uiff/lorawan-wifi-ble-scanner/cad/export/Gehaeuse_Oben.stl

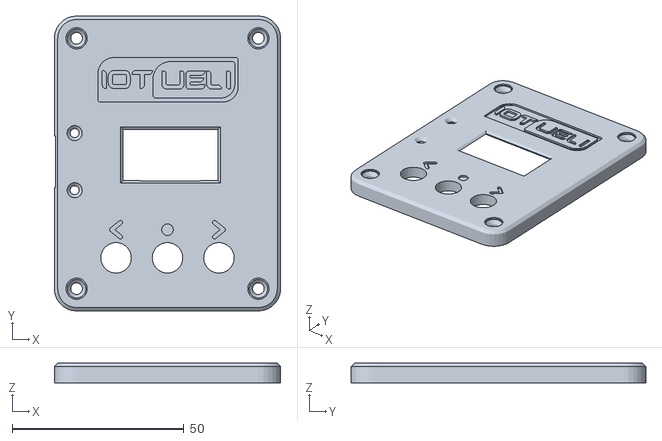
[picture p9: CAD file, 2026-10-29]
cad/export/Gehaeuse_Oben.stl
66.0 x 86.0 x 5.70
