uiff/lorawan-wifi-ble-scanner/cad/export/Gehaeuse_Unten.stl

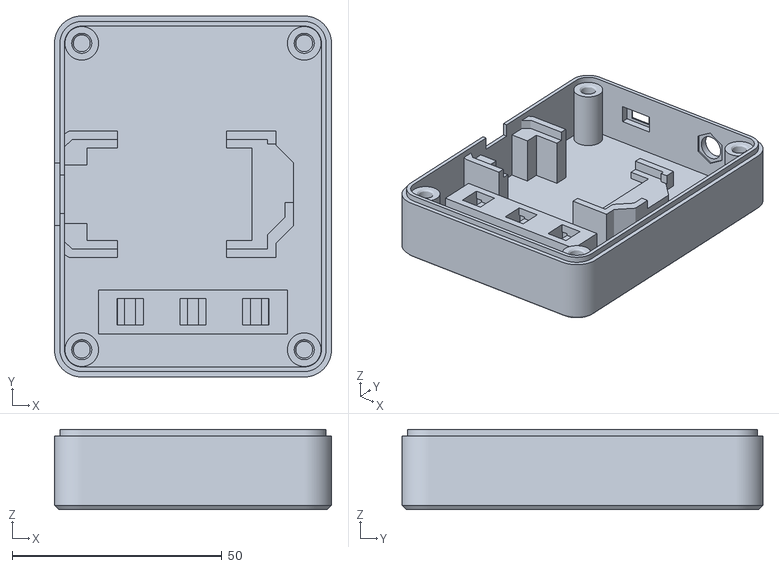
[picture p10: CAD file, 2026-10-29]
cad/export/Gehaeuse_Unten.stl
66.0 x 86.0 x 19.1
