uiff/lorawan-wifi-ble-scanner/cad/export/Taster_Kappe.stl

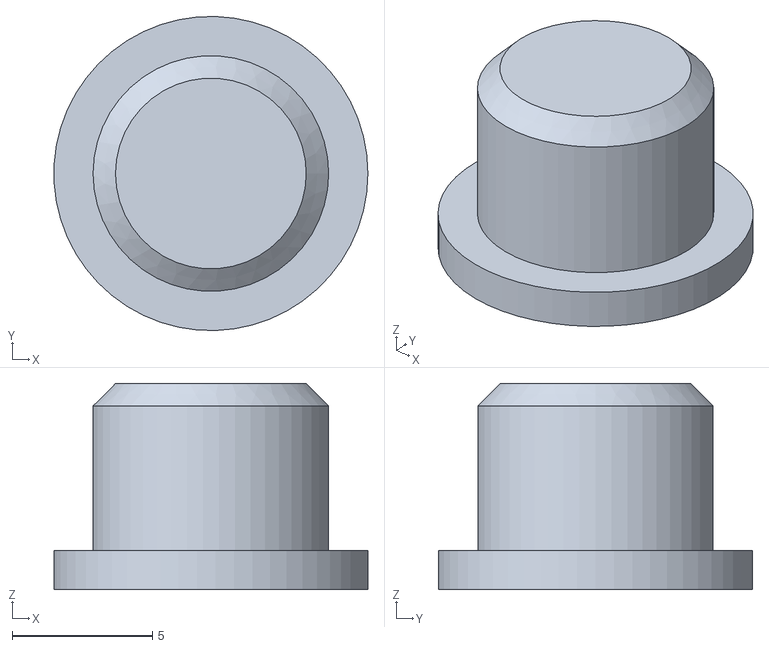
[picture p11: CAD file, 2026-10-29]
cad/export/Taster_Kappe.stl
11.2 x 11.2 x 7.35
