uiff/lorawan-wifi-ble-scanner/cad/export/LoraWanFinder_BambuLab_Platte.3mf

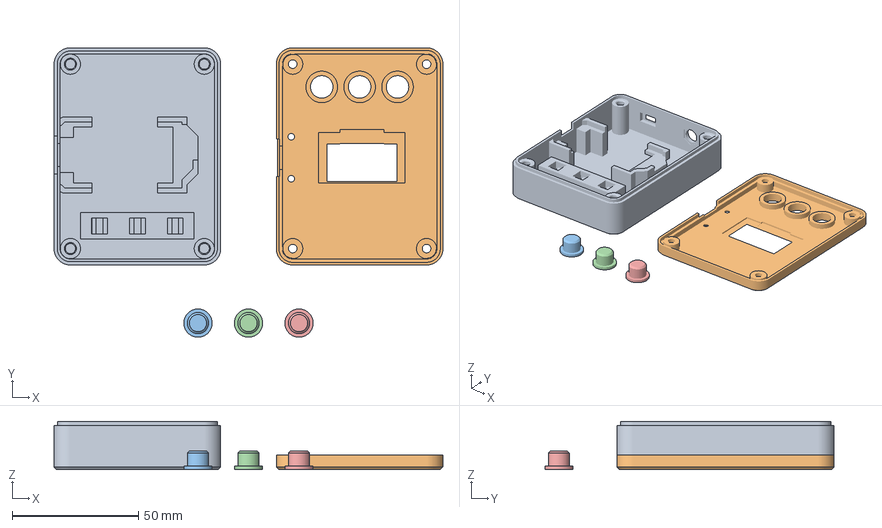
[picture p12: CAD file, 2026-10-29]
cad/export/LoraWanFinder_BambuLab_Platte.3mf
154.0 x 114.6 x 19.1 mm
Gehaeuse_Unten
Gehaeuse_Oben
Taster_Kappe_1
Taster_Kappe_2
Taster_Kappe_3
