uiff/lorawan-wifi-ble-scanner/cad/export/Logo_und_Tasten_Farbe2.stl

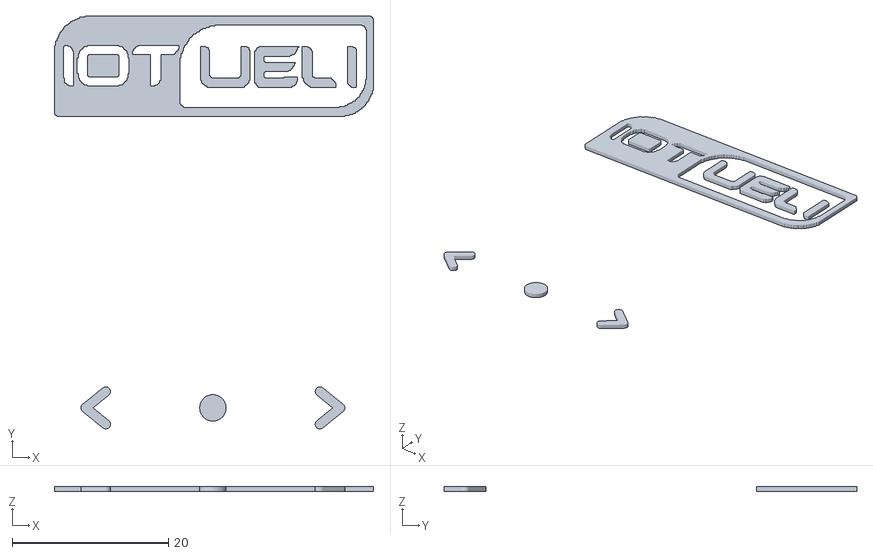
[picture p13: CAD file, 2026-10-29]
cad/export/Logo_und_Tasten_Farbe2.stl
40.8 x 52.9 x 0.6
