uiff/lorawan-wifi-ble-scanner/(commit log)

2026-10-29 Initial release: 3-in-1 LoRaWAN / WiFi / BLE Finder, Bambu Lab 3MF/STL enclosure (Rev. 5) & PDF manual
    [Gehaeuse_Oben.stl, Gehaeuse_Unten.stl, Logo_und_Tasten_Farbe2.stl, LoraWanFinder.FCStd, LoraWanFinder_BambuLab_Platte.3mf, Taster_Kappe.stl]
2026-10-29 Keep only cad/export files in repository
    [LoraWanFinder.FCStd]
2026-10-29 Reduce repository to firmware, print data and PDF manual
